kj7dz/GPS-clock/README.md

# GPS-Clock

 This GPS clock is based clock original GPS clock project from Bruce Hall's (W8BH) [web site.](http://w8bh.net)
 The orignal arduino sketch came from his [Github site](https://github.com/bhall66/GPS-clock)
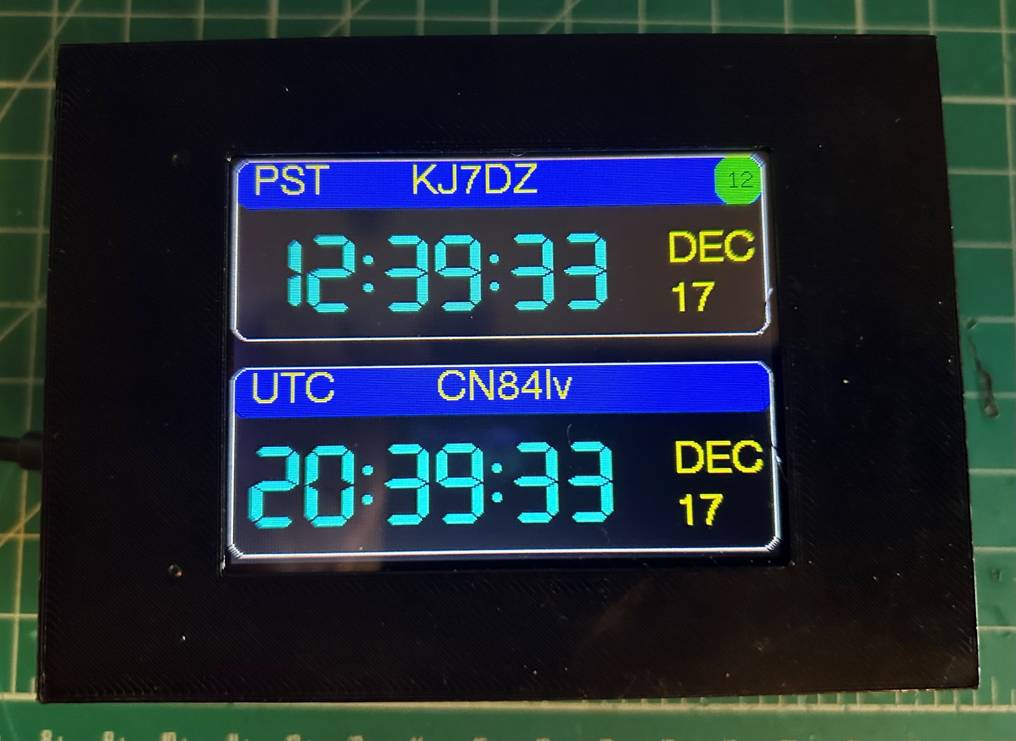
[picture p1: images/assembly-small.jpg]
 
* Features
	* (3) unique displays (GPS Time, UTC/Local Time, GPS Location and time)
	* Personal CALL sign
	* GRID square location
	* 12/24 Local time
	* 24 UTC time
	* 6-24 VDC operation
	* Useful in the shack, POTA or SOTA
* [Assembly](https://github.com/kj7dz/GPS-clock/blob/main/documentation/Assembly%20instructions%20for%20GPS%20clock.pdf)
* [Software / Programming](documentation/Software.md)

## Hardware
**Bill of Materials**

This is the list of components to build a GPS Clock.  You may already have some of these parts.

| Item | Qty | Part | Link | Approx Price |
| --- | --- | --- | --- | --- |
| 1. | 1 | Printed Circuit Board | [link](mailto:fhoonhout@yahoo.com) | $10.00
| 2. | 1 | STM32F103CBT6 (128K) | [link](https://www.ebay.com/itm/146271505505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) | $ 17.10
| 3. | 1 | 3.2" ILI9341 TFT LCD Display | [link](https://www.amazon.com/DIANN-ILI9341-Display-320x240-Screen/dp/B0BNQD38T2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) | $14.00
| 4. | 1 | GPS+BDS Dual Mode module | [link](https://www.amazon.com/DWEII-Dual-Mode-Satellite-Positioning-Replacement/dp/B0B68C1W94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) | $12.00
| 5. | 1 | MP1584EN DC-DC Buck Converter | [link](https://www.amazon.com/DZS-Elec-Converter-Adjustable-Regulator/dp/B07JWGN1F6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) | $ 7.59
| 6. | 1 | 1N4001 Diode | [link](https://www.amazon.com/FAIRCHILD-SEMICONDUCTOR-1N4001-STANDARD-pieces/dp/B00LQPV2KA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) | $ 4.94
| 7. | 2 | 40 pin female socket pin header | [link](https://www.amazon.com/ZYAMY-2-54mm-Female-Straight-Connector/dp/B0778F2MLW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) | $ 5.98 
| 8. | 1 | 40 pin male pin header | [link](https://www.amazon.com/MCIGICM-Header-2-45mm-Arduino-Connector/dp/B07PKKY8BX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) | $ 5.98 
| 9. | 1 | 5.5 / 2.1mm power plug/socket | [link](https://www.amazon.com/dp/B08SJM2G52?ref=ppx_yo2ov_dt_b_fed_asin_title) | $10.90
| 10.  | 1 | ST-link V2 USB programmer | [link](https://www.amazon.com/HiLetgo-Emulator-Downloader-Programmer-STM32F103C8T6/dp/B07SQV6VLZ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) | $ 9.49
| 11. | 1 | 3D Printed Case | [link](https://www.thingiverse.com/thing:6877107) | Thingiverse

**Fully assembled GPS Clock and KIT are available** _(includes programming)_

**Material details**
* **PCB** - The PCB can be order directly from KJ7DZ. _(includes shipping)_
* **STM32** - The STM32 controller comes in 32K, 64K or 128K versions. Sketch just fits into 64k of ROM flash.
	* STM32F103C**6**T6 - **32K**
	* STM32F103C**8**T6 - **64K**
	* STM32F103C**B**T6 - **128K**
* **3.2" TFT LCD Display** - Be sure the display supports 3.3V and touch screen.
* **GPS module** - In some situations the included GPS antenna may not work. A [28db High Gain antenna](https://www.amazon.com/Ceramic-Navigation-Receiver-Tracking-Interface/dp/B0C3H6BKHC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) maybe needed.
* **DC-DC Buck converter** - It is **CRITICAL** to set the buck converter to **3.3 VDC** output.
* **1N4001 diode** - The diode is for reverse voltage protection.  A similar diode can be used.
* **Power connectors** - The socket wires can be solder directly to the PCB or use a molex connector.

**Contributers**

| Bruce | W8BH |
| --- | --- |
| Ken | WB2ART |
| Frank | KJ7DZ |
