kj7dz/GPS-clock/images/Board Settings.png

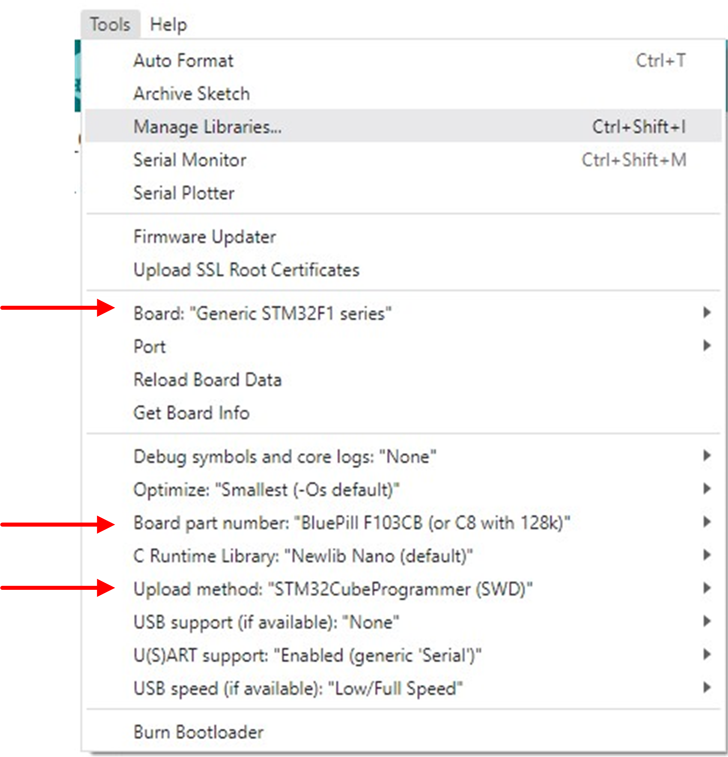
images/Board Settings.png
