kj7dz/GPS-clock/images/Case & display.jpg

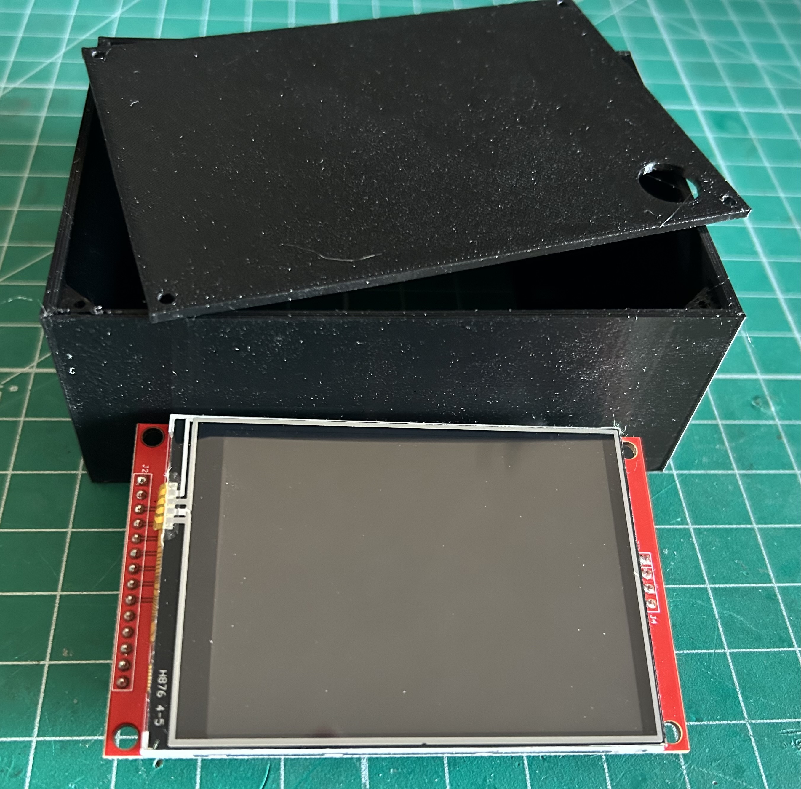
images/Case & display.jpg
