kj7dz/GPS-clock/images/Device Mgr.jpg

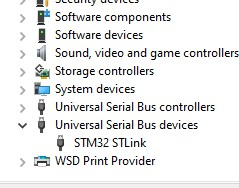
images/Device Mgr.jpg
