kj7dz/GPS-clock/images/Display headers.jpg

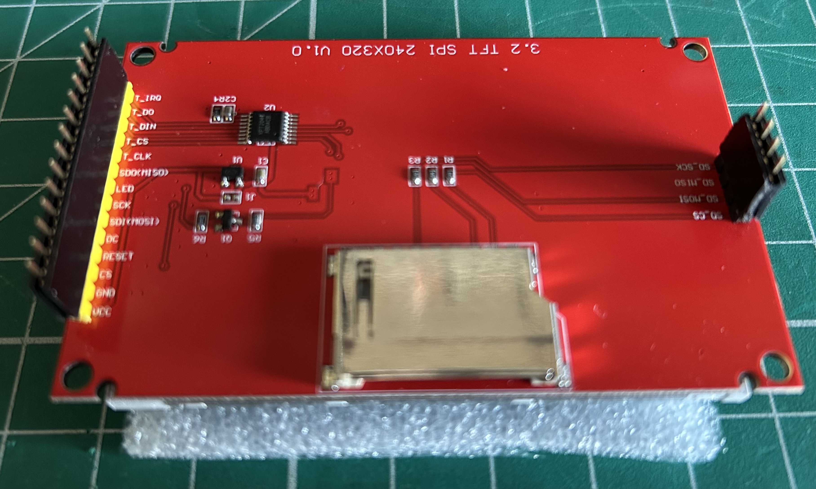
images/Display headers.jpg
