kj7dz/GPS-clock/images/GPS header.jpg

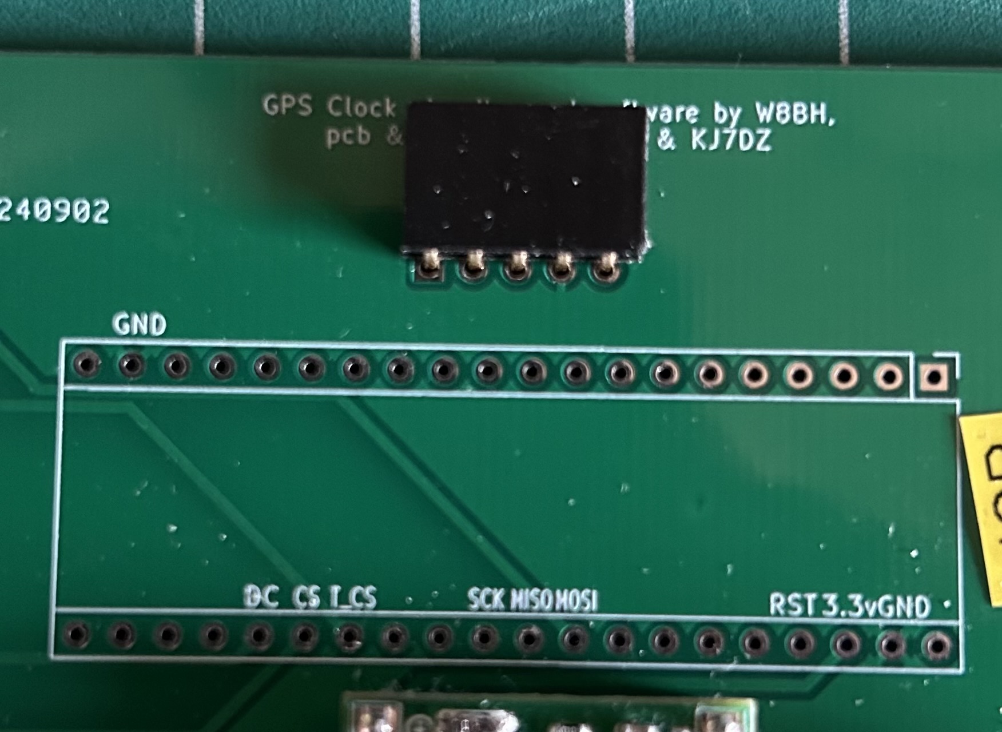
images/GPS header.jpg
