kj7dz/GPS-clock/images/GPS sketch.jpg

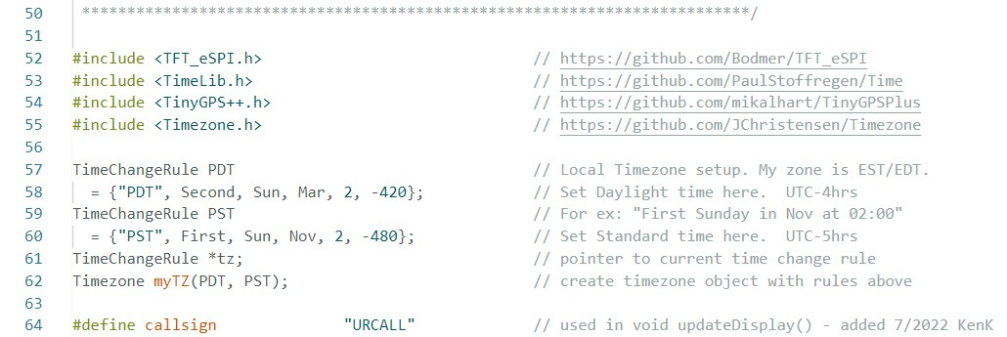
images/GPS sketch.jpg
