kj7dz/GPS-clock/images/GPS.jpg

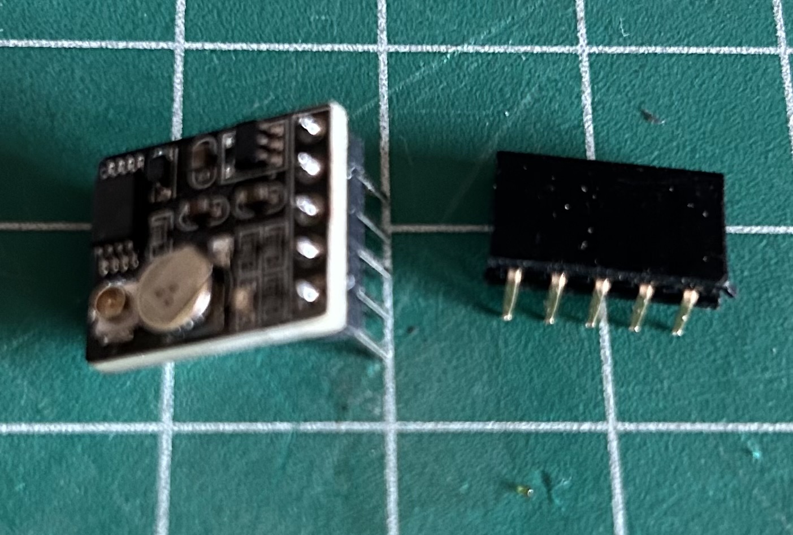
images/GPS.jpg
