kj7dz/GPS-clock/images/IDE modules.jpg

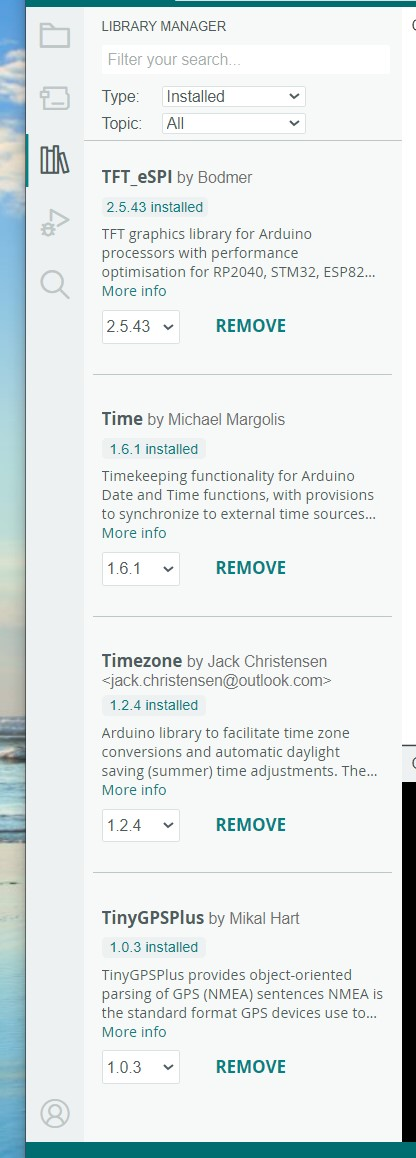
images/IDE modules.jpg
