kj7dz/GPS-clock/images/Program header.jpg

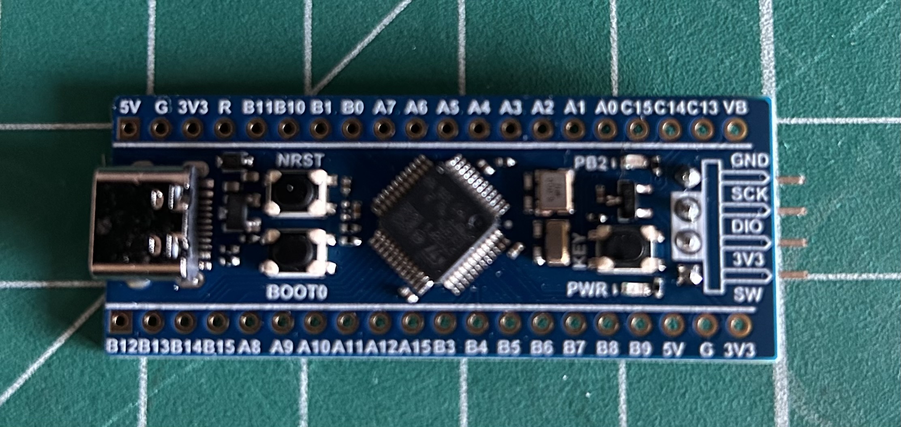
images/Program header.jpg
