kj7dz/GPS-clock/images/Programmer 1.png

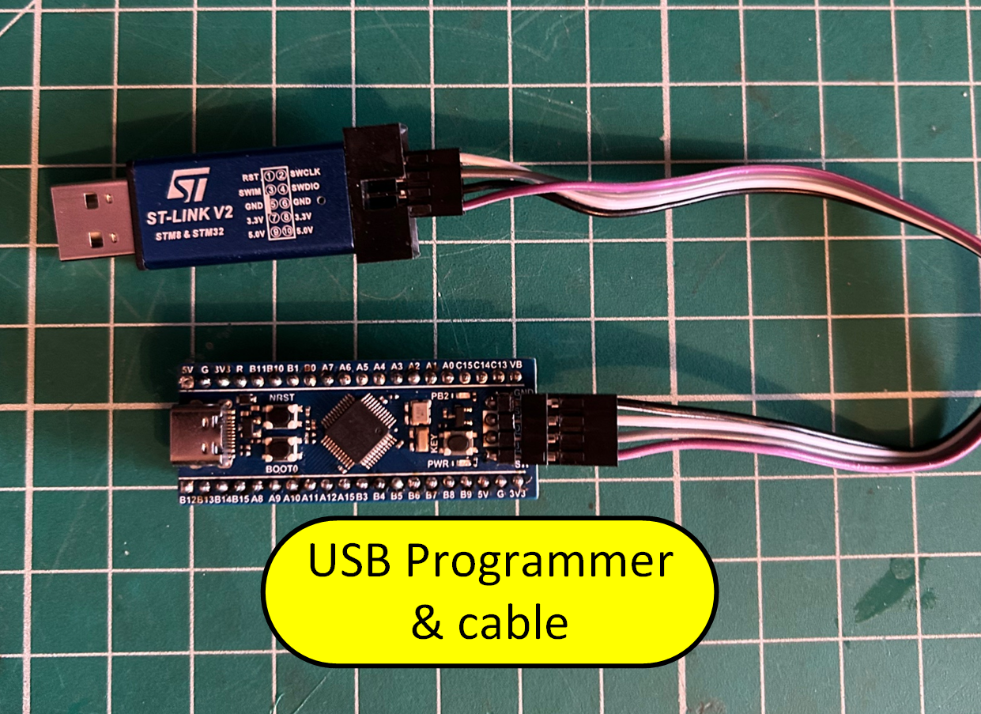
images/Programmer 1.png
