kj7dz/GPS-clock/images/STM32 header.jpg

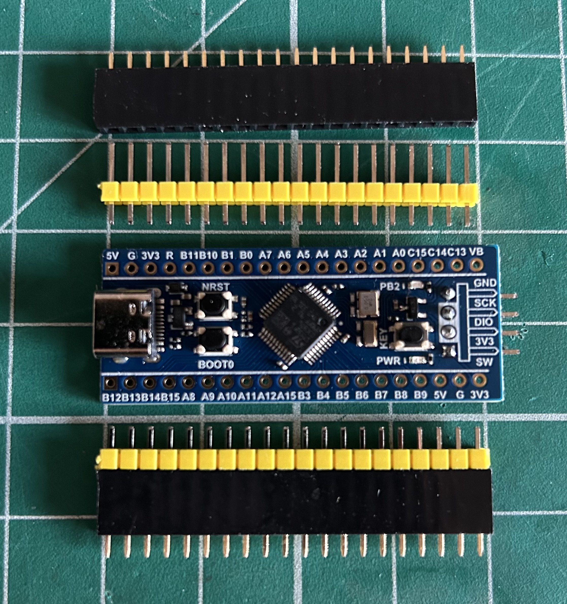
images/STM32 header.jpg
