kj7dz/GPS-clock/documentation/3D printed enclosure assembly.pdf

## 3D printed enclosure assembly

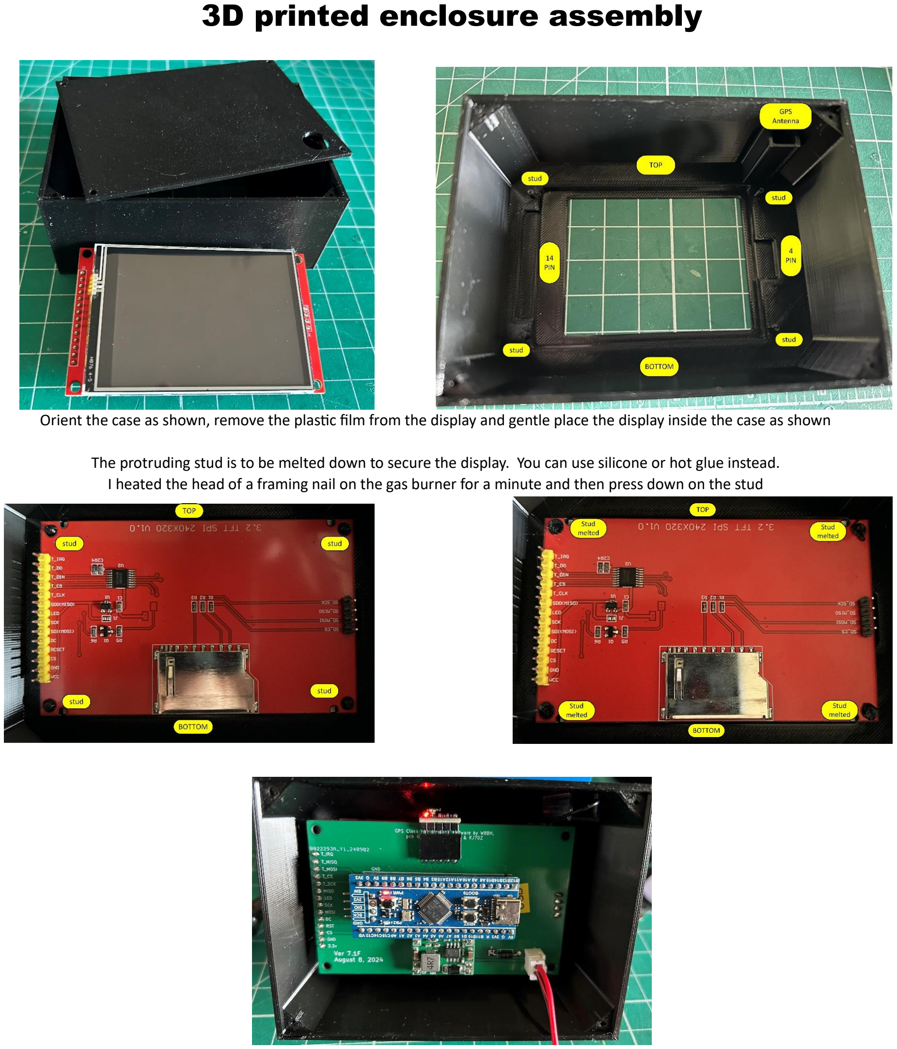
[picture p20: page 1]

Orient the case as shown, remove the plastic film from the display and gentle place the display inside the case as shown

The protruding stud is to be melted down to secure the display. You can use silicone or hot glue instead.
I heated the head of a framing nail on the gas burner for a minute and then press down on the stud
