kj7dz/GPS-clock/images/assembly.jpg

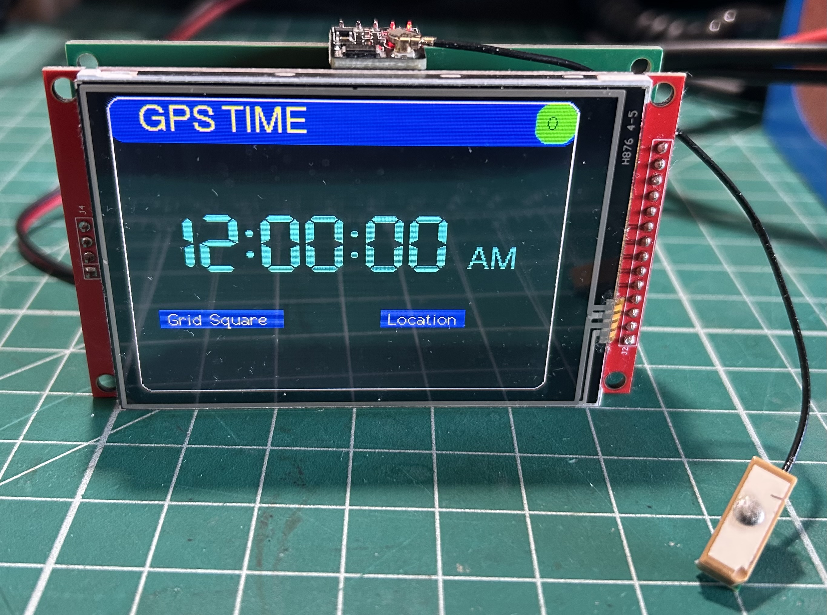
images/assembly.jpg
