kj7dz/GPS-clock/images/display solder.jpg

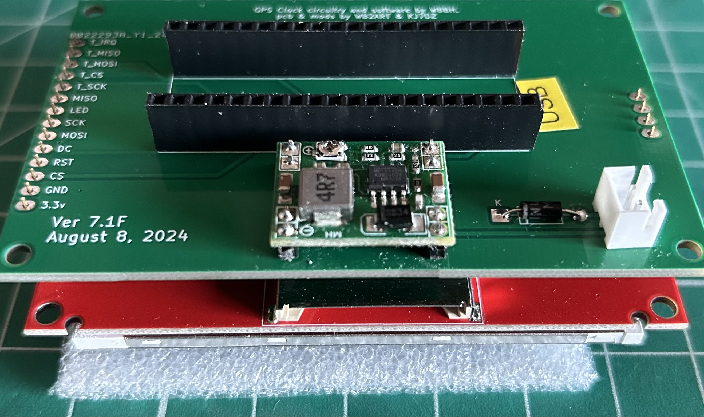
images/display solder.jpg
