kj7dz/GPS-clock/images/STM32 solder header.jpg

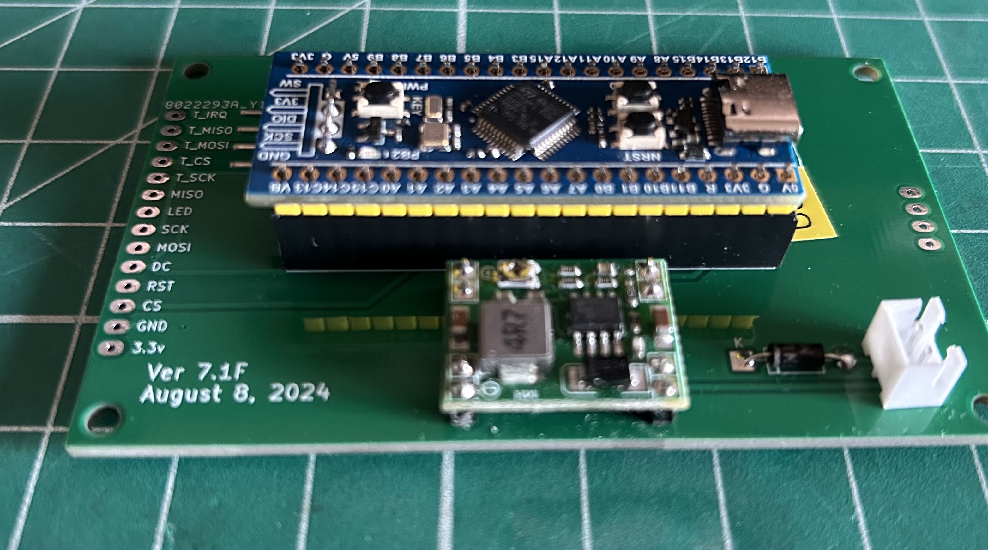
images/STM32 solder header.jpg
