kj7dz/GPS-clock/images/power up test.jpg

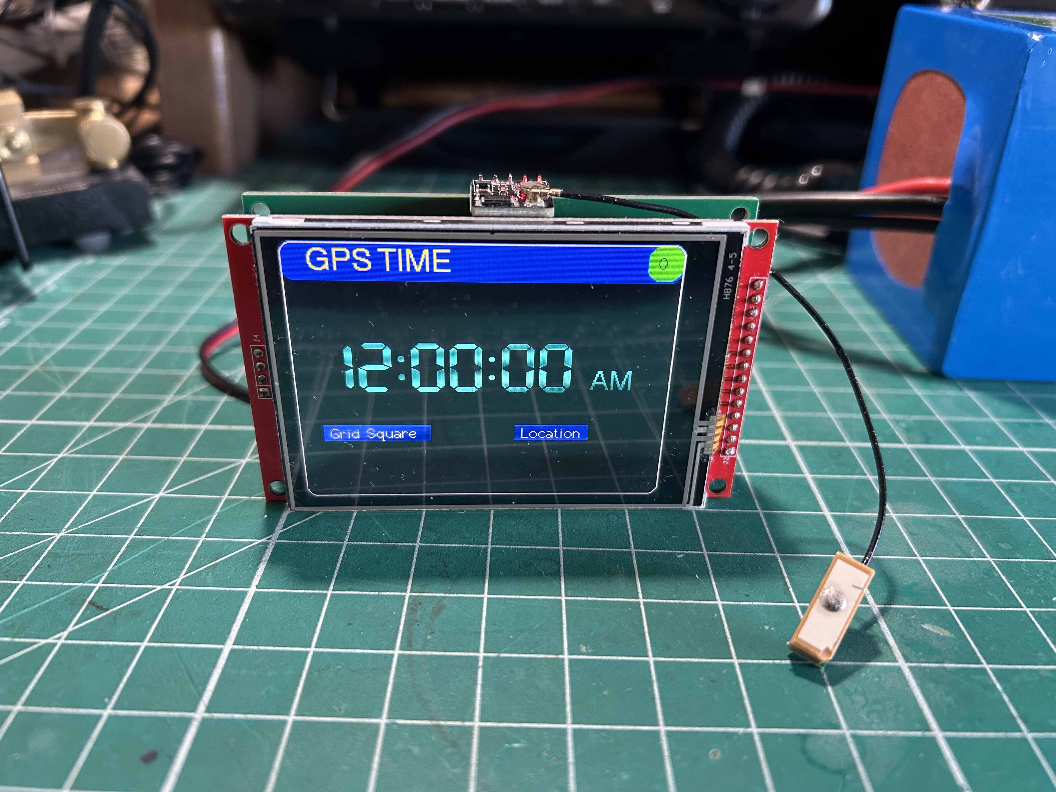
images/power up test.jpg
