kj7dz/GPS-clock/(commit log)

2024-12-18 Create Board Settings.png
2024-12-18 Create Device Mgr.jpg
2025-02-08 Update Software.md
    STM32 link
2026-10-01 Fix typo in upload instructions for Arduino IDE
